snjung/Loconet/README.md

# Loconet
Alles rund um Modellbahn, Arduino und Loconet
