snjung/Loconet/hardware/loconet - Kopie/loconet.kicad_pcb

## KiCad design hardware/loconet - Kopie/loconet.kicad_pcb (2020-11-08)

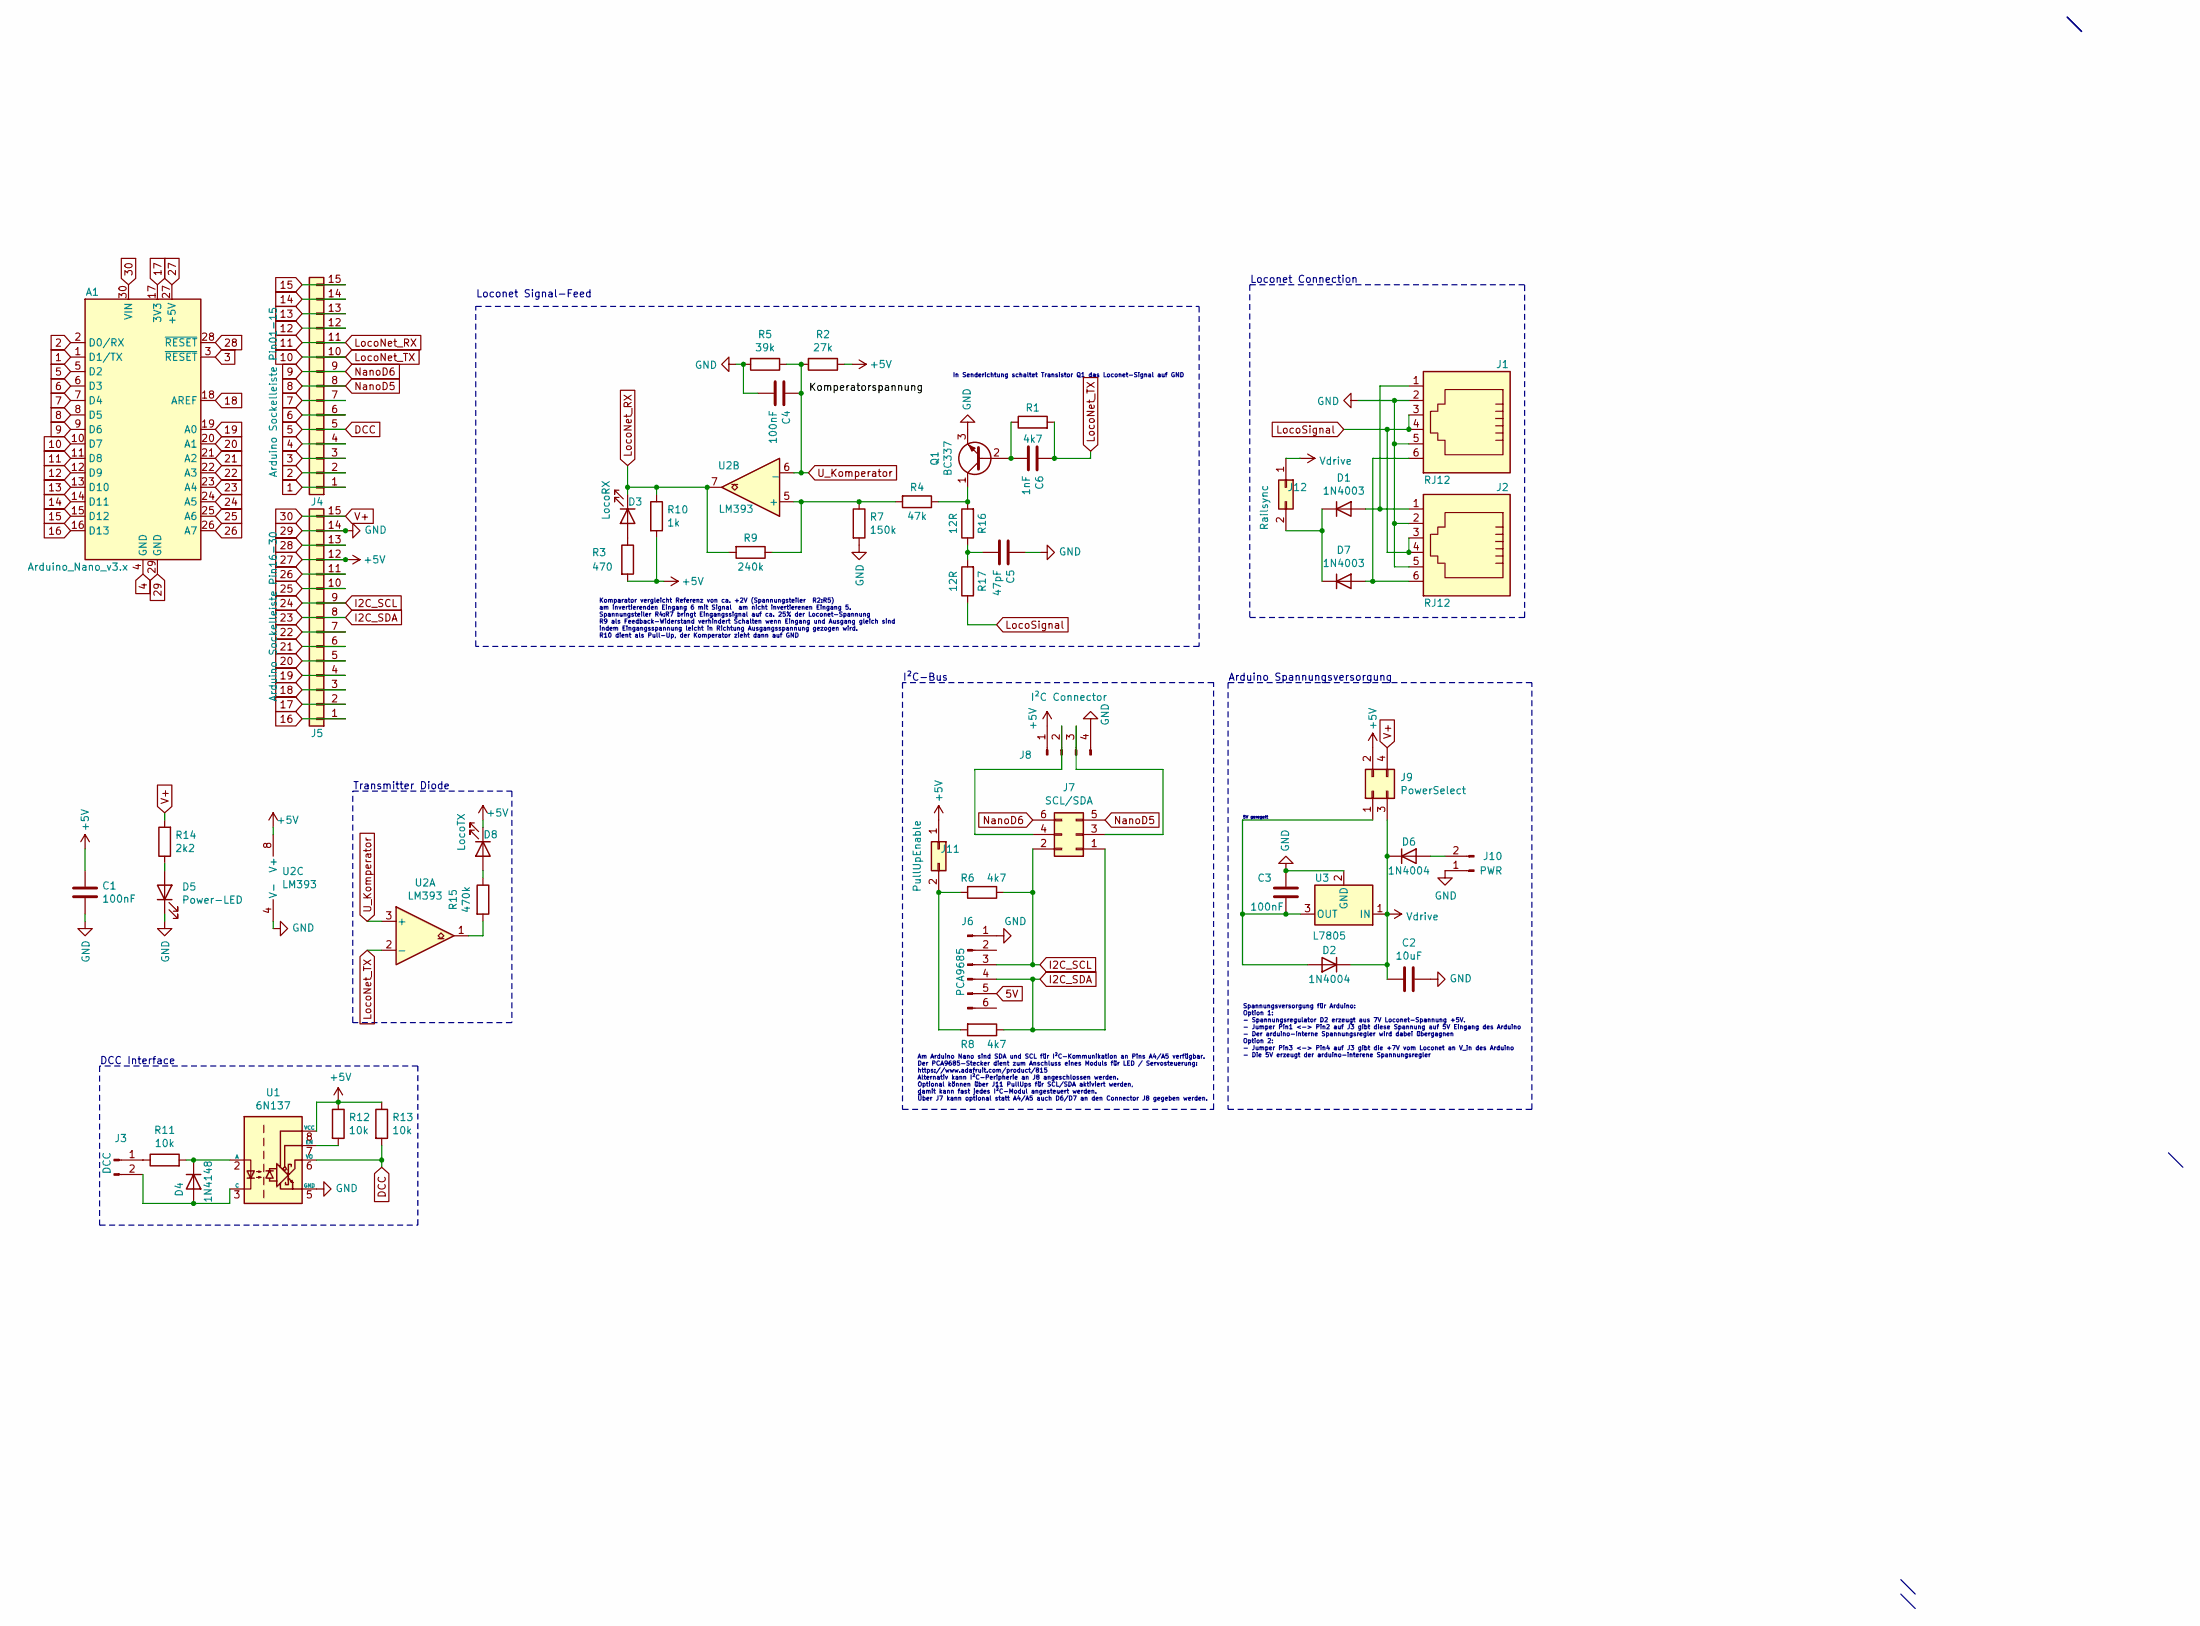
[picture p1: schematic loconet.sch, Arduino <-> Loconet Interface]

Parts:
A1: Arduino_Nano_v3.x; Arduino_Nano
C1, C3, C4: 100nF; C_Disc_D4.3mm_W1.9mm_P5.00mm
C2: 10uF; C_Radial_D12.5mm_H20.0mm_P5.00mm
C5: 47pF; C_Disc_D4.3mm_W1.9mm_P5.00mm
C6: 1nF; C_Disc_D4.3mm_W1.9mm_P5.00mm
D1, D7: 1N4003; D_DO-41_SOD81_P10.16mm_Horizontal
D2, D6: 1N4004; D_DO-41_SOD81_P10.16mm_Horizontal
D3: LocoRX; LED_D3.0mm
D4: 1N4148; D_DO-35_SOD27_P7.62mm_Horizontal
D5: Power-LED; LED_D3.0mm
D8: LocoTX; LED_D3.0mm
J1, J2: RJ12; RJ12_Amphenol_54601
J3: DCC; JST_EH_B2B-EH-A_1x02_P2.50mm_Vertical
J4: Arduino Sockelleiste Pin01-15; PinSocket_1x15_P2.54mm_Vertical
J5: Arduino Sockelleiste Pin16-30; PinSocket_1x15_P2.54mm_Vertical
J6: PCA9685; JST_EH_B6B-EH-A_1x06_P2.50mm_Vertical
J7: SCL/SDA; PinHeader_2x03_P2.54mm_Vertical
J8: I²C Connector; JST_EH_B4B-EH-A_1x04_P2.50mm_Vertical
J9: PowerSelect; PinHeader_2x02_P2.54mm_Vertical
J10: PWR; JST_EH_B2B-EH-A_1x02_P2.50mm_Vertical
J11: PullUpEnable; PinHeader_2x01_P2.54mm_Vertical
J12: Railsync; PinHeader_2x01_P2.54mm_Vertical
Q1: BC337; TO-92_Inline
R1, R6, R8: 4k7; R_Axial_DIN0207_L6.3mm_D2.5mm_P7.62mm_Horizontal
R2: 27k; R_Axial_DIN0207_L6.3mm_D2.5mm_P7.62mm_Horizontal
R3: 470; R_Axial_DIN0207_L6.3mm_D2.5mm_P7.62mm_Horizontal
R4: 47k; R_Axial_DIN0207_L6.3mm_D2.5mm_P7.62mm_Horizontal
R5: 39k; R_Axial_DIN0207_L6.3mm_D2.5mm_P7.62mm_Horizontal
R7: 150k; R_Axial_DIN0207_L6.3mm_D2.5mm_P7.62mm_Horizontal
R9: 240k; R_Axial_DIN0207_L6.3mm_D2.5mm_P7.62mm_Horizontal
R10: 1k; R_Axial_DIN0207_L6.3mm_D2.5mm_P7.62mm_Horizontal
R11, R12, R13: 10k; R_Axial_DIN0207_L6.3mm_D2.5mm_P7.62mm_Horizontal
R14: 2k2; R_Axial_DIN0207_L6.3mm_D2.5mm_P7.62mm_Horizontal
R15: 470k; R_Axial_DIN0207_L6.3mm_D2.5mm_P7.62mm_Horizontal
R16, R17: 12R; R_Axial_DIN0207_L6.3mm_D2.5mm_P7.62mm_Horizontal
U1: 6N137; DIP-8_W7.62mm
U2: LM393; DIP-8_W7.62mm_LongPads
U3: L7805; TO-220-3_Vertical

Connections:
1: A1.1 (D1/TX), J4.1
2: A1.2 (D0/RX), J4.2
3: A1.3 (~RESET), J4.3
4: A1.4 (GND), J4.4
5: A1.5 (D2), J4.5, R13.2, U1.6 (VO)
5V: J6.5
6: A1.6 (D3), J4.6
7: A1.7 (D4), J4.7
8: A1.8 (D5), J4.8, J7.5
9: A1.9 (D6), J4.9, J7.6
10: A1.10 (D7), C6.1, J4.10, R1.2, U2.2 (-)
11: A1.11 (D8), D3.1 (K), J4.11, R9.2, R10.1, U2.7
12: A1.12 (D9), J4.12
13: A1.13 (D10), J4.13
14: A1.14 (D11), J4.14
15: A1.15 (D12), J4.15
16: A1.16 (D13), J5.1
17: A1.17 (3V3), J5.2
18: A1.18 (AREF), J5.3
19: A1.19 (A0), J5.4
20: A1.20 (A1), J5.5
21: A1.21 (A2), J5.6
22: A1.22 (A3), J5.7
23: A1.23 (A4), J5.8, J6.4, J7.1, R8.1
24: A1.24 (A5), J5.9, J6.3, J7.2, R6.1
25: A1.25 (A6), J5.10
26: A1.26 (A7), J5.11
27: A1.27 (+5V), C1.1, D8.1 (K), J5.12, J8.1, J9.2, J11.1, R2.1, R3.2, R10.2, R12.1, R13.1, U1.8 (VCC), U2.8 (V+)
28: A1.28 (~RESET), J5.13
29: A1.29 (GND), C1.2, C2.1, C3.1, C4.2, C5.1, D5.1 (K), J1.2, J1.5, J2.2, J2.5, J5.14, J6.1, J8.4, J10.1, Q1.3 (E), R5.2, R7.2, U1.5 (GND), U2.4 (V-), U3.2 (GND)
30: A1.30 (VIN), J5.15, J9.4, R14.2
LocoSignal: J1.3, J1.4, J2.3, J2.4, R17.1
unnamed: C3.2, D2.2 (A), J9.1, U3.3 (OUT)
unnamed: C5.2, R16.1, R17.2
unnamed: C6.2, Q1.2 (B), R1.1
unnamed: D1.1 (K), D7.1 (K), J12.2
unnamed: D1.2 (A), J1.1, J2.1
unnamed: D3.2 (A), R3.1
unnamed: D4.1 (K), R11.2, U1.2 (A)
unnamed: D4.2 (A), J3.2, U1.3 (C)
unnamed: D5.2 (A), R14.1
unnamed: D6.2 (A), J10.2
unnamed: D7.2 (A), J1.6, J2.6
unnamed: D8.2 (A), R15.1
unnamed: J3.1, R11.1
unnamed: J7.3, J8.3
unnamed: J7.4, J8.2
unnamed: J11.2, R6.2, R8.2
unnamed: Q1.1 (C), R4.1, R16.2
unnamed: R4.2, R7.1, R9.1, U2.5 (+)
unnamed: R12.2, U1.7 (EN)
unnamed: R15.2, U2.1
U_Komperator: C4.1, R2.2, R5.1, U2.3 (+), U2.6 (_)
Vdrive: C2.2, D2.1 (K), D6.1 (K), J9.3, J12.1, U3.1 (IN)

Notes on the sheet:
Loconet Connection
Loconet Signal-Feed
DCC Interface
Komparator vergleicht Referenz von ca. +2V (Spannungsteiler R2:R5) am invertierenden Eingang 6 mit Signal am nicht invertierenen Eingang 5. Spannungsteiler R4:R7 bringt Eingangssignal auf ca. 25% der Loconet-Spannung R9 als Feedback-Widerstand verhindert Schalten wenn Eingang und Ausgang gleich sin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
In Senderichtung schaltet Transistor Q1 das Loconet-Signal auf GND
5V geregelt
Spannungsversorgung für Arduino: Option 1: - Spannungsregulator D2 erzeugt aus 7V Loconet-Spannung +5V. - Jumper Pin1 <-> Pin2 auf J3 gibt diese Spannung auf 5V Eingang des Arduino - Der arduino-interne Spannungsregler wird dabei übergagnen Option 2: - Jumper Pin3 <-> Pin4 auf J3 gibt die +7V vom L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
Am Arduino Nano sind SDA und SCL für I²C-Kommunikation an Pins A4/A5 verfügbar. Der PCA9685-Stecker dient zum Anschluss eines Moduls für LED / Servosteuerung: https://www.adafruit.com/product/815 Alternativ kann I²C-Peripherie an J8 angeschlossen werden. Optional können über J11 PullUps für SCL/SDA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
I²C-Bus
Arduino Spannungsversorgung
Transmitter Diode

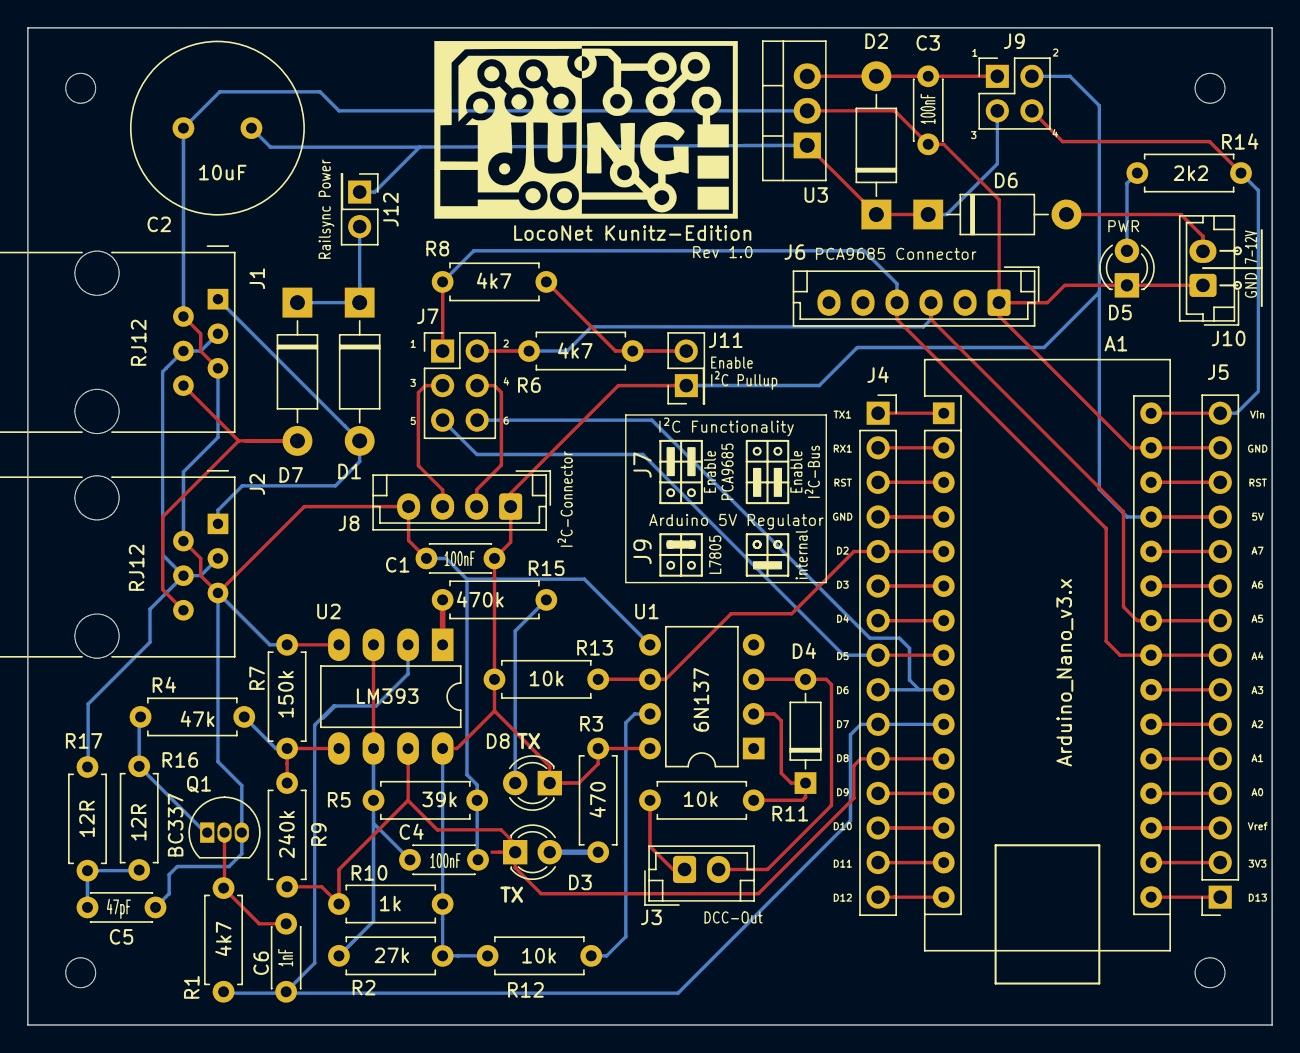
[picture p2: board loconet.kicad_pcb from above]

Board: 2 copper layers, 91.4 x 73.3 mm, 50 parts (0 on the bottom side), 53 nets.

Other parts of the board:
LOGO**: board-title
LOGO***: LOGO; JungLogo
