snjung/Loconet/(commit log)

2020-10-31 Platinendesign für Loconet-Arduino-Schnittstelle erstellt
    [loconet.kicad_pcb, loconet.sch]
2020-11-03 Add variant hardware with loconet TX indicator LED
    [loconet.kicad_pcb, loconet.sch]
2020-11-03 Einige Verbesserungen am PCB Layout
    [loconet.kicad_pcb, loconet.sch]
2020-11-08 Added some capacitors
    [loconet.kicad_pcb, loconet.sch]
